langei/CE2DX3_Final_Project/CAD/uHousing.stl

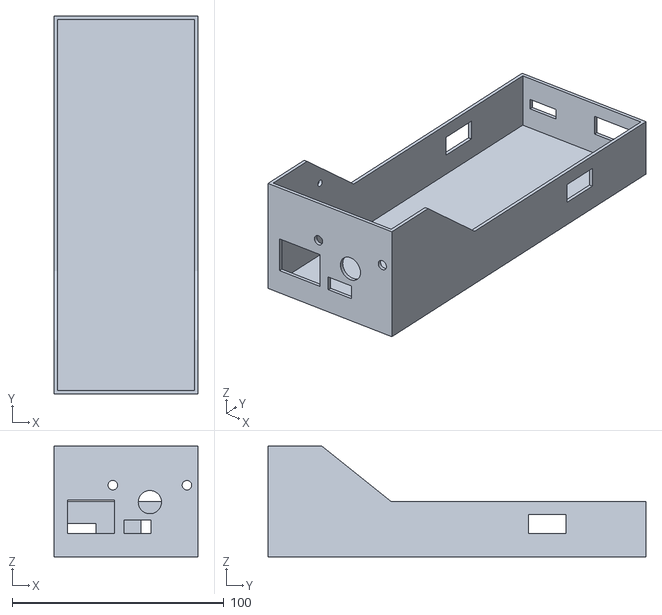
[picture p7: CAD file, 2023-04-11]
CAD/uHousing.stl
67.9 x 178.4 x 52.4
