langei/CE2DX3_Final_Project/CAD/TOFMount.stl

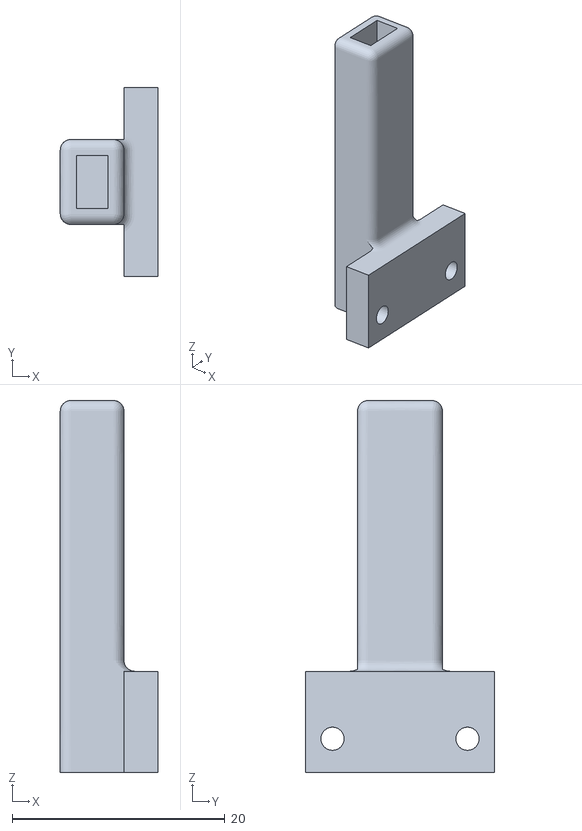
[picture p8: CAD file, 2023-04-11]
CAD/TOFMount.stl
9.18 x 17.8 x 35.0
