langei/CE2DX3_Final_Project/(list of files, cad)

Other CAD files:
CAD/OldVersions/TOFMount.0004.ipt
CAD/OldVersions/uHousing.0006.ipt
CAD/TOFMount.ipt
CAD/uHousing.ipt
