langei/CE2DX3_Final_Project/Deliverable2/i2c.h

/* COMPENG 2DX3 Final Project
 * Ivan Lange
 * April 12, 2023
 * main.c
 *
 *
 * Assumes system clock of 12 MHz
 */
 
 
/*********************************************************
*                       INCLUDES
*********************************************************/
#include "tm4c1294ncpdt.h"
#include <stdint.h>
#include "PLL.h"
#include "SysTick.h"

/*********************************************************
*                        MACROS
*********************************************************/
#define I2C_MCS_ACK             0x00000008  // Data Acknowledge Enable
#define I2C_MCS_DATACK          0x00000008  // Acknowledge Data
#define I2C_MCS_ADRACK          0x00000004  // Acknowledge Address
#define I2C_MCS_STOP            0x00000004  // Generate STOP
#define I2C_MCS_START           0x00000002  // Generate START
#define I2C_MCS_ERROR           0x00000002  // Error
#define I2C_MCS_RUN             0x00000001  // I2C Master Enable
#define I2C_MCS_BUSY            0x00000001  // I2C Busy
#define I2C_MCR_MFE             0x00000010  // I2C Master Function Enable

#define MAXRETRIES              5           // number of receive attempts before giving up


/*********************************************************
*              PUBLIC FUNCTION DEFINITIONS
*********************************************************/
void I2C_Init(void){
  SYSCTL_RCGCI2C_R |= SYSCTL_RCGCI2C_R0;           													// activate I2C0
  SYSCTL_RCGCGPIO_R |= SYSCTL_RCGCGPIO_R1;          												// activate port B
  while((SYSCTL_PRGPIO_R&0x0002) == 0){};																		// ready?

    GPIO_PORTB_AFSEL_R |= 0x0C;           																	// 3) enable alt funct on PB2,3       0b00001100
    GPIO_PORTB_ODR_R |= 0x08;             																	// 4) enable open drain on PB3 only

    GPIO_PORTB_DEN_R |= 0x0C;             																	// 5) enable digital I/O on PB2,3
//    GPIO_PORTB_AMSEL_R &= ~0x0C;          																// 7) disable analog functionality on PB2,3

                                                                            // 6) configure PB2,3 as I2C
//  GPIO_PORTB_PCTL_R = (GPIO_PORTB_PCTL_R&0xFFFF00FF)+0x00003300;
  GPIO_PORTB_PCTL_R = (GPIO_PORTB_PCTL_R&0xFFFF00FF)+0x00002200;    //TED
    I2C0_MCR_R = I2C_MCR_MFE;                      													// 9) master function enable
    I2C0_MTPR_R = 0b0000000000000101000000000111011;                       	// 8) configure for 100 kbps clock (added 8 clocks of glitch suppression ~50ns)
    //I2C0_MTPR_R = 0x3B;                                        						// 8) configure for 100 kbps clock
        
}
