langei/CE2DX3_Final_Project/Deliverable2/uart.c

/* COMPENG 2DX3 Final Project
 * Ivan Lange
 * April 12, 2023
 * main.c
 *
 *
 * Assumes system clock of 12 MHz
 */
 
 
/*********************************************************
*                       INCLUDES
*********************************************************/
#include "uart.h"
#include "tm4c1294ncpdt.h"
#include <stdint.h>
#include <stdio.h>


/*********************************************************
*                 FUNCTION DECLARATIONS
*********************************************************/
//Initialize UART0, based on textbook.  Clock code modified.
void UART_Init(void) {
	SYSCTL_RCGCUART_R |= 0x0001; // activate UART0   
	SYSCTL_RCGCGPIO_R |= 0x0001; // activate port A   
	//UART0_CTL_R &= ~0x0001; // disable UART   

	while((SYSCTL_PRUART_R&SYSCTL_PRUART_R0) == 0){};
		
  UART0_CTL_R &= ~UART_CTL_UARTEN;      // disable UART
  UART0_IBRD_R = 8;                     // IBRD = int(16,000,000 / (16 * 115,200)) = int(8.681)
  UART0_FBRD_R = 44;                    // FBRD = round(0.6806 * 64) = 44
                                        // 8 bit word length (no parity bits, one stop bit, FIFOs)
  UART0_LCRH_R = (UART_LCRH_WLEN_8|UART_LCRH_FEN);
                                        // UART gets its clock from the alternate clock source as defined by SYSCTL_ALTCLKCFG_R
  UART0_CC_R = (UART0_CC_R&~UART_CC_CS_M)+UART_CC_CS_PIOSC;
                                        // the alternate clock source is the PIOSC (default)
  SYSCTL_ALTCLKCFG_R = (SYSCTL_ALTCLKCFG_R&~SYSCTL_ALTCLKCFG_ALTCLK_M)+SYSCTL_ALTCLKCFG_ALTCLK_PIOSC;
  UART0_CTL_R &= ~UART_CTL_HSE;         // high-speed disable; divide clock by 16 rather than 8 (default)

	UART0_LCRH_R = 0x0070;		// 8-bit word length, enable FIFO   
	UART0_CTL_R = 0x0301;			// enable RXE, TXE and UART   
	GPIO_PORTA_PCTL_R = (GPIO_PORTA_PCTL_R&0xFFFFFF00)+0x00000011; // UART   
	GPIO_PORTA_AMSEL_R &= ~0x03;	// disable analog function on PA1-0   
	GPIO_PORTA_AFSEL_R |= 0x03;		// enable alt funct on PA1-0   
	GPIO_PORTA_DEN_R |= 0x03;			// enable digital I/O on PA1-0 
}

// Wait for new input, then return ASCII code 
char UART_InChar(void){
		while((UART0_FR_R&0x0010) != 0);		// wait until RXFE is 0   
		return((char)(UART0_DR_R&0xFF));
	} 
	
	// Wait for buffer to be not full, then output 
void UART_OutChar(char data){
		while((UART0_FR_R&0x0020) != 0);	// wait until TXFF is 0   
		UART0_DR_R = data;
	} 
	
	//send a string of characters to uart
void UART_printf(const char* array){
		int ptr=0;
		while(array[ptr]){
			UART_OutChar(array[ptr]);
			ptr++;
		}
	}
	
void Status_Check(char* array, int status){
			if (status != 0){
				UART_printf(array);
				sprintf(printf_buffer," failed with (%d)\r\n",status);
				UART_printf(printf_buffer);
			}else
			{
				UART_printf(array);
				UART_printf(" Successful.\r\n");
			}
	}
