langei/CE2DX3_Final_Project/(commit log)

2023-04-11 Add stepper.h, other header files
    [TOFMount.0004.ipt, TOFMount.ipt, TOFMount.stl, uHousing.0006.ipt, uHousing.ipt, uHousing.stl]
2023-04-11 Integrate motor with scanner code
